tweedegolf/spaeter/firmware/src/adc_capture.rs

mod ring_buffer;
pub mod timing;

use fugit::HertzU32;
use hal::{
    pac,
    rcc::{self, BusClock, BusTimerClock, Clocks, Enable, Reset, AHB1, APB1, APB2},
};
use ring_buffer::{DmaGrant, DoubleBufferedRingBuffer};
use stm32f7xx_hal as hal;
pub use timing::{SampleIndex, TimerObservations, TimerValue};

const CAPTURE_LEN: usize = AdcCapture::CONVS_PER_CHUNK * AdcCapture::BUF_NUM_CHUNKS;

/// A fixed sized buffer that is used as backing storage of the ring buffer
pub type AdcCaptureBuffer = [u16; CAPTURE_LEN];

#[derive(Debug, Clone, Copy, defmt::Format)]
enum StreamMemoryBank {
    Bank0,
    Bank1,
}

/// A wrapper around all resources that are needed to capture data from the ADC to a ring buffer
///
/// It handles all hardware configurations, interrupts, and data ownership.
pub struct AdcCapture {
    adc_common: pac::ADC_COMMON,
    adc1: pac::ADC1,
    tim2: pac::TIM2,
    dma2: pac::DMA2,
    buffer: DoubleBufferedRingBuffer,
    next_done: StreamMemoryBank,
    pub(crate) adc_clk: HertzU32,
    pub(crate) tim2_clk: HertzU32,
}

impl AdcCapture {
    /// Number of conversions the DMA will store before switching to a new buffer
    pub const CONVS_PER_CHUNK: usize = 1024 * 8;

    /// Number of chunks that make up the ring buffer
    pub const BUF_NUM_CHUNKS: usize = 4;

    /// Initialize all hardware used
    ///
    /// This connects up the peripherals in a chain. When TIM2 starts counting it causes ADC1 to
    /// start conversions. When an ADC conversion is done the data is fetched by the DMA. The ADC
    /// keeps performing conversions and TIM2 keeps counting, allowing correlation between ADC
    /// sample and timer counts.
    ///
    /// The configurations happen in the following order:
    ///
    /// # Initialize DMA2 channel 0
    /// Configure DMA2 Stream 0 to read 16-bit conversions from ADC1
    /// and write them into the internal buffer in double-buffer mode.
    ///
    /// Double-buffer mode means that the DMA holds two pointers into our buffer. One that is
    /// currently being written to, and another that is switched to once the first is done.
    /// This allows us to take our time with feeding the DMA a new slice to write to. For more
    /// information see STM32F767ZI reference manual chapter 8.3.10.
    ///
    /// This enables the DMA2 interrupt for transfer complete or any errors.
    ///
    /// # Initialize ADC1
    /// Configure ADC1 to 12-bits resolution in continuous conversion mode and to be triggered
    /// externally from TIM2 TRGO, and read out using DMA.
    ///
    /// Triggering the ADC from TIM2 ensures that both started on the same clock cycle. This can
    /// then be used to calculate at which TIM2 count a specific sample was captured.
    ///
    /// This **has to be** setup before TIM2, otherwise TIM2 will already run before the
    /// ADC started.
    ///
    /// # Initialize TIM2
    /// Setup TIM2 to trigger ADC1 via TRGO on start. Let the timer run from 0..=u32::MAX at full
    /// speed, causing an **interrupt** on overflow. Connect the PTP alarm signal through to capture
    /// channel 1 on rising edges, also causing an **interrupt** on capture.
    ///
    /// Add the end TIM2 is started, which also starts ADC1.
    #[allow(clippy::too_many_arguments)]
    pub fn init(
        buffer: &'static mut AdcCaptureBuffer,
        adc_common: pac::ADC_COMMON,
        adc1: pac::ADC1,
        tim2: pac::TIM2,
        dma2: pac::DMA2,
        apb1: &mut APB1,
        apb2: &mut APB2,
        ahb1: &mut AHB1,
        clocks: &Clocks,
    ) -> Self {
        let mut this = Self {
            adc_common,
            adc1,
            tim2,
            dma2,
            buffer: DoubleBufferedRingBuffer::new(buffer),
            next_done: StreamMemoryBank::Bank0,
            adc_clk: HertzU32::Hz(0),
            tim2_clk: HertzU32::Hz(0),
        };

        this.init_dma2(ahb1);
        this.init_adc1(apb2, clocks);
        this.init_tim2(apb1, clocks);

        // Inits should also have initialized clock rates
        assert_ne!(this.adc_clk, HertzU32::Hz(0));
        assert_ne!(this.tim2_clk, HertzU32::Hz(0));

        this
    }

    /// See Self::init for docs
    fn init_dma2(&mut self, ahb1: &mut rcc::AHB1) {
        let dma2_stream0 = &self.dma2.st[0];
        <pac::DMA2 as Enable>::enable(ahb1);
        // Disable DMA2 Stream 0
        dma2_stream0.cr.modify(|_, w| w.en().disabled());

        // Choose channel 0 for DMA2 Stream 0
        dma2_stream0.cr.modify(|_, w| {
            // Select channel 0 (ADC1)
            w.chsel()
                .bits(0)
                // Enable Double-buffer mode
                .dbm()
                .enabled()
                // Disable circular mode
                .circ()
                .disabled()
                // Set data size to 16 bits at memory side
                .msize()
                .bits16()
                // Set data size to 16 bits at peripheral side
                .psize()
                .bits16()
                // Increment memory pointer after each read
                .minc()
                .incremented()
                // Do not increment peripheral data pointer
                .pinc()
                .fixed()
                // Write from peripheral to memory
                .dir()
                .peripheral_to_memory()
                // DMA controls when transfer ends (which is never due to circular mode)
                .pfctrl()
                .dma()
                // Enable Transfer Complete Interrupt
                .tcie()
                .enabled()
                // Enable Transfer Error Interrupt
                .teie()
                .enabled()
                // Enable Direct Mode Error Interrupt
                .dmeie()
                .enabled()
                // Select Memory 0 to start
                .ct()
                .memory0()
        });

        // Set buffer size
        dma2_stream0
            .ndtr
            .modify(|_, w| w.ndt().bits(Self::CONVS_PER_CHUNK.try_into().unwrap()));

        // Set peripheral address to ADC1 data register
        dma2_stream0
            .par
            .write(|w| unsafe { w.pa().bits(self.adc1.dr.as_ptr() as u32) });

        // Point DMA Memory 0 to first chunk of data buffer
        dma2_stream0.m0ar.write(|w| unsafe {
            w.m0a()
                .bits(self.buffer.next_dma_buffer().unwrap().as_mut_ptr() as u32)
        });
        // Point DMA Memory 1 to second chunk of data buffer
        dma2_stream0.m1ar.write(|w| unsafe {
            w.m1a()
                .bits(self.buffer.next_dma_buffer().unwrap().as_mut_ptr() as u32)
        });

        // Enable DMA2 Stream 0
        dma2_stream0.cr.modify(|_, w| w.en().enabled());
    }

    /// See init for docs
    fn init_adc1(&mut self, apb2: &mut APB2, clocks: &Clocks) {
        let adc1 = &self.adc1;
        <pac::ADC1 as Enable>::enable(apb2);
        // Power down ADC1
        adc1.cr2.modify(|_, w| w.adon().clear_bit());
        <pac::ADC1 as Reset>::reset(apb2);

        // Setup ADC1 for continuous conversion mode
        adc1.cr2.modify(|_, w| w.cont().continuous());
        adc1.cr1
            .modify(|_, w| w.scan().clear_bit().discen().clear_bit());

        // Setup ADC1 for external triggering by TIM2 TRGO
        adc1.cr2
            .modify(|_, w| unsafe { w.exten().rising_edge().extsel().bits(0b1011) });

        // Setup ADC1 resolution to 12 bit
        adc1.cr1.modify(|_, w| w.res().bits(0b00));

        // Enable DMA on ADC1
        adc1.cr2.modify(|_, w| w.dma().enabled().dds().continuous());

        // Disable ADC end-of-conversion interrupt, enable overrun interrupt
        adc1.cr1
            .modify(|_, w| w.eocie().disabled().ovrie().enabled());

        // Use PA3 as input
        adc1.sqr3.modify(|_, w| unsafe { w.sq1().bits(3) });

        adc1.smpr2.write(|w| w.smp0().cycles480());
        self.adc_common.ccr.modify(|_, w| w.adcpre().div4());

        // Power up ADC1
        adc1.cr2.modify(|_, w| w.adon().enabled());

        self.adc_clk = APB2::clock(clocks) / 4;
    }

    /// See init for docs
    fn init_tim2(&mut self, apb1: &mut APB1, clocks: &Clocks) {
        let tim2 = &self.tim2;
        <pac::TIM2 as Enable>::enable(apb1);
        // Set Master mode trigger on timer enable, which will enable ADC1 as well
        tim2.cr2.modify(|_, w| w.mms().enable());
        // ARR resets to u32::MAX
        tim2.arr.write(|w| w.arr().bits(u32::MAX));

        // Enable TIM2 CC1 capture interrupt as well as update interrupt to detect overflows
        tim2.dier.modify(|_, w| w.uie().enabled().cc1ie().enabled());

        // Connect PTP to TIM2 ITR1
        tim2.or.write(|w| unsafe { w.itr1_rmp().bits(0b01) });
        // Connect TIM2 ITR1 to ITR
        tim2.smcr.modify(|_, w| w.ts().itr1());

        // Configures TIM2 CC1 to capture the timer value on ITR
        tim2.ccmr1_input()
            .modify(|_, w| unsafe { w.cc1s().trc().ic1f().no_filter().ic1psc().bits(0b00) });

        // Enable TIM2
        tim2.cr1.modify(|_, w| w.cen().enabled());

        // TODO: shouldn't we first setup everything and then enable the timer?
        // Set CC1 to only capture on a rising edge
        tim2.ccer
            .modify(|_, w| w.cc1p().clear_bit().cc1np().clear_bit());
        tim2.cr2.modify(|_, w| w.ti1s().normal()); // TODO: is this really needed? if so add a comment why

        // Enable CC1
        tim2.ccer.modify(|_, w| w.cc1e().set_bit());

        self.tim2_clk = APB1::timer_clock(clocks);
    }

    /// Handle DMA2 interrupt
    ///
    /// 1. Clears all interrupt flags.
    /// 2. Raises a panic if an error occurred.
    /// 3. Switches out the finished buffer, getting a fresh slice from the ring buffer and
    ///    returning the finished slice to the ring buffer for the app to consume.
    pub fn dma_interrupt_handler(&mut self) {
        // Reset interrupt flag
        let lisr = self.dma2.lisr.read();
        self.dma2.lifcr.write(|w| unsafe { w.bits(lisr.bits()) });

        let hisr = self.dma2.hisr.read();
        self.dma2.hifcr.write(|w| unsafe { w.bits(hisr.bits()) });

        // Fetch status
        let stream0 = &self.dma2.st[0];

        // Check if we hit an error
        if lisr.teif0().is_error() || lisr.dmeif0().is_error() || lisr.feif0().is_error() {
            panic!("DMA error on stream 0");
        }
        if lisr.teif1().is_error()
            || lisr.dmeif1().is_error()
            || lisr.feif1().is_error()
            || lisr.teif2().is_error()
            || lisr.dmeif2().is_error()
            || lisr.feif2().is_error()
            || lisr.teif3().is_error()
            || lisr.dmeif3().is_error()
            || lisr.feif3().is_error()
            || hisr.bits() != 0
        {
            panic!("DMA error on some stream >0");
        }

        // ADC transfer is done
        if lisr.tcif0().is_complete() {
            let memory_reg = match self.next_done {
                StreamMemoryBank::Bank0 => stream0.m0ar.as_ptr(),
                StreamMemoryBank::Bank1 => stream0.m1ar.as_ptr(),
            };

            let next_buf = self
                .buffer
                .next_dma_buffer()
                .expect("Ran out of buffer space")
                .as_mut_ptr() as u32;

            let old = unsafe { DmaGrant::from_ptr(memory_reg.read_volatile() as *mut _) };
            unsafe { memory_reg.write_volatile(next_buf) };

            self.buffer.dma_done(old);
            self.next_done = match self.next_done {
                StreamMemoryBank::Bank0 => StreamMemoryBank::Bank1,
                StreamMemoryBank::Bank1 => StreamMemoryBank::Bank0,
            };
        }
    }

    /// Get the currently available data in the ring buffer
    ///
    /// This returns the index of the first sample of this data, since the start of the DMA. And
    /// two slices with the data. If the ring buffer currently does not cross the first element the
    /// second slice is empty.
    pub fn data_buffer(&self) -> (SampleIndex, (&[u16], &[u16])) {
        (self.buffer.first_idx(), self.buffer.app_data())
    }

    /// Free data from the ring buffer
    ///
    /// This makes the space available again to the DMA to fill.
    pub fn release_data(&mut self, num_samples: usize) {
        self.buffer.app_done(num_samples);
    }
}
