tweedegolf/spaeter/firmware/src/ptp_clock.rs

use core::cell::RefCell;

use az::{Cast, SaturatingCast};
use critical_section::Mutex;
use embedded_time::{rate::Fraction, Instant};
use fixed::types::{I33F31, U96F32};
use stm32_eth::ptp::{EthernetPTP, Timestamp};

pub struct PtpClock {
    inner: Mutex<RefCell<EthernetPTP>>,
    addend_starter_frequency: f64,
}

impl PtpClock {
    pub fn new(ethernet_ptp: EthernetPTP) -> Self {
        let start_addend = ethernet_ptp.addend();
        let addend_starter_frequency = u32::MAX as f64 / start_addend as f64;

        Self {
            inner: Mutex::new(RefCell::new(ethernet_ptp)),
            addend_starter_frequency,
        }
    }

    pub fn access<R>(&self, f: impl FnOnce(&mut EthernetPTP) -> R) -> R {
        critical_section::with(|cs| f(&mut self.inner.borrow_ref_mut(cs)))
    }
}

pub fn stm_time_to_statime(timestamp: stm32_eth::ptp::Timestamp) -> statime::time::Time {
    let seconds: U96F32 = I33F31::from_bits(timestamp.raw()).cast();
    let nanos = seconds * 1_000_000_000u128;
    statime::time::Time::from_fixed_nanos(nanos)
}

impl statime::Clock for &PtpClock {
    type Error = core::convert::Infallible;

    fn now(&self) -> statime::time::Time {
        stm_time_to_statime(EthernetPTP::get_time())
    }

    fn step_clock(
        &mut self,
        offset: statime::time::Duration,
    ) -> Result<statime::time::Time, Self::Error> {
        let seconds = offset.nanos() / 1_000_000_000i128;
        let seconds: I33F31 = seconds.cast();

        defmt::println!("Stepping {}", defmt::Display2Format(&offset));

        self.access(|clock| {
            clock.update_time(Timestamp::new_raw(seconds.to_bits()));
        });

        Ok(self.now())
    }

    fn set_frequency(&mut self, ppm: f64) -> Result<statime::time::Time, Self::Error> {
        let freq = 1.0 + ppm / 1_000_000.0;

        defmt::info!("Ppm offset is: {}. Setting frequency to: {}", ppm, freq);

        let total_frequency = self.addend_starter_frequency / freq;
        let addend = u32::MAX as f64 / total_frequency;

        self.access(|clock| {
            clock.set_addend(addend.saturating_cast());
        });

        Ok(self.now())
    }

    fn set_properties(
        &mut self,
        _time_properties_ds: &statime::config::TimePropertiesDS,
    ) -> Result<(), Self::Error> {
        Ok(())
    }
}

impl embedded_time::Clock for &PtpClock {
    type T = u32;

    const SCALING_FACTOR: embedded_time::rate::Fraction = Fraction::new(1, 1000);

    fn try_now(&self) -> Result<embedded_time::Instant<Self>, embedded_time::clock::Error> {
        let nanos = <Self as statime::Clock>::now(self).nanos();
        let millis = nanos / 1_000_000;
        Ok(Instant::new(millis.to_num()))
    }
}
