tweedegolf/spaeter/(commit log)

2023-10-17 Create firmware crate based on statime-stm32, and start on figuring out DMA and ADC on this thing
2023-10-18 configure ADC1 based on stm32cubeide generated code
2023-10-19 Make DMA work
2023-10-23 Fix tiny, but very annoying typo
    [main.rs]
2023-10-26 Enable PTP trigger signal to capture TIM2 timer to CC1
2023-10-26 Move peripheral init code to new adc_capture mod, start on adc buffer abstraction
2023-11-07 Deal much better with noise and push detected locations to mqtt
    [lib.rs, main.rs, signal.rs, signal_correlator.rs, signal_locator.rs, signal_peak_processor.rs]
2023-11-15 Update config so device can connect to mqtt
2023-11-27 Update compiler and no longer allow faulty lint
    The lint is fixed in this ompiler version
    [main.rs]
2023-11-27 Implement dma interrupt handler
2023-11-27 Track global index of first sample and let users access data
2023-11-27 Add adc capture to firmware
2024-01-16 First draft for hw
    [debug.kicad_sch, ethernet.kicad_sch, mcu.kicad_sch, microphone.kicad_sch, node-prototype.kicad_pcb, node-prototype.kicad_sch, power-supply.kicad_sch, usb.kicad_sch]
2024-01-16 Route RMII, power and debug lines on MCU, route PHY power lines
    [ethernet.kicad_sch, mcu.kicad_sch]
2024-01-16 Route ethernet PHY and connector
    [ethernet.kicad_sch]
2024-01-16 Add symbol and foodprint for MYBSP00502ABF, route PoE
    [ethernet.kicad_sch, power-supply.kicad_sch]
2024-01-16 Design USB iface
    [usb.kicad_sch]
2024-01-16 Add a draft for VDetect for SWD over USB-C
    [usb.kicad_sch]
2024-01-17 Clean up mcu sheet
    [mcu.kicad_sch]
2024-01-17 Clean up ethernet sheet, design power supply
    [ethernet.kicad_sch, power-supply.kicad_sch]
2024-01-17 Import labels in root sheet
    [node-prototype.kicad_sch]
2024-01-17 Design microphone component
    [microphone.kicad_sch]
2024-01-19 Add footprint for mic
2024-01-19 Add footprint for button
2024-01-19 WIP on user interface
    [debug.kicad_sch, ethernet.kicad_sch, mcu.kicad_sch, microphone.kicad_sch, node-prototype.kicad_sch, power-supply.kicad_sch, usb.kicad_sch, user-interface.kicad_sch]
2024-01-19 Plug schematic together
    [debug.kicad_sch, ethernet.kicad_sch, mcu.kicad_sch, microphone.kicad_sch, node-prototype.kicad_sch, power-supply.kicad_sch, usb.kicad_sch, user-interface.kicad_sch]
2024-01-23 Design PPS output, fix LEDs and their resistors
    [ethernet.kicad_sch, mcu.kicad_sch, microphone.kicad_sch, node-prototype.kicad_sch, power-supply.kicad_sch, pps.kicad_sch, usb.kicad_sch, user-interface.kicad_sch]
2024-01-23 ESD protect uart pins, connect POE_DET to mcu
    [debug.kicad_sch, mcu.kicad_sch]
2024-01-23 Assign footprints
    [ethernet.kicad_sch, pps.kicad_sch]
2024-01-23 Slow down adc + fix dma
    [adc_capture.rs, main.rs, timing.rs]
2024-01-23 WIP on pcb layout
    [node-prototype.kicad_pcb]
2024-01-29 Layout ethernet, mic, power
    [debug.kicad_sch, ethernet.kicad_sch, node-prototype.kicad_pcb, power-supply.kicad_sch]
2024-02-01 Double check schematic
    [ethernet.kicad_sch, mcu.kicad_sch, microphone.kicad_sch, node-prototype.kicad_sch, power-supply.kicad_sch, pps.kicad_sch, usb.kicad_sch, user-interface.kicad_sch]
2024-02-01 Finish placement
    [ethernet.kicad_sch, mcu.kicad_sch, node-prototype.kicad_pcb, node-prototype.kicad_sch, pps.kicad_sch]
2024-02-01 Finish routing
    [ethernet.kicad_sch, node-prototype.kicad_pcb]
2024-02-02 prepare for production
    [debug.kicad_sch, ethernet.kicad_sch, microphone.kicad_sch, node-prototype.kicad_pcb, node-prototype.kicad_sch, power-supply.kicad_sch, pps.kicad_sch, usb.kicad_sch]
2024-02-02 ready for production
    [node-prototype.kicad_pcb]
2024-02-07 Fix timing capture to use capture channel
    [main.rs]
